ULAS-HiPR/tortilla/payload_carrier.kicad_pcb

## KiCad design payload_carrier.kicad_pcb (2026-10-15)

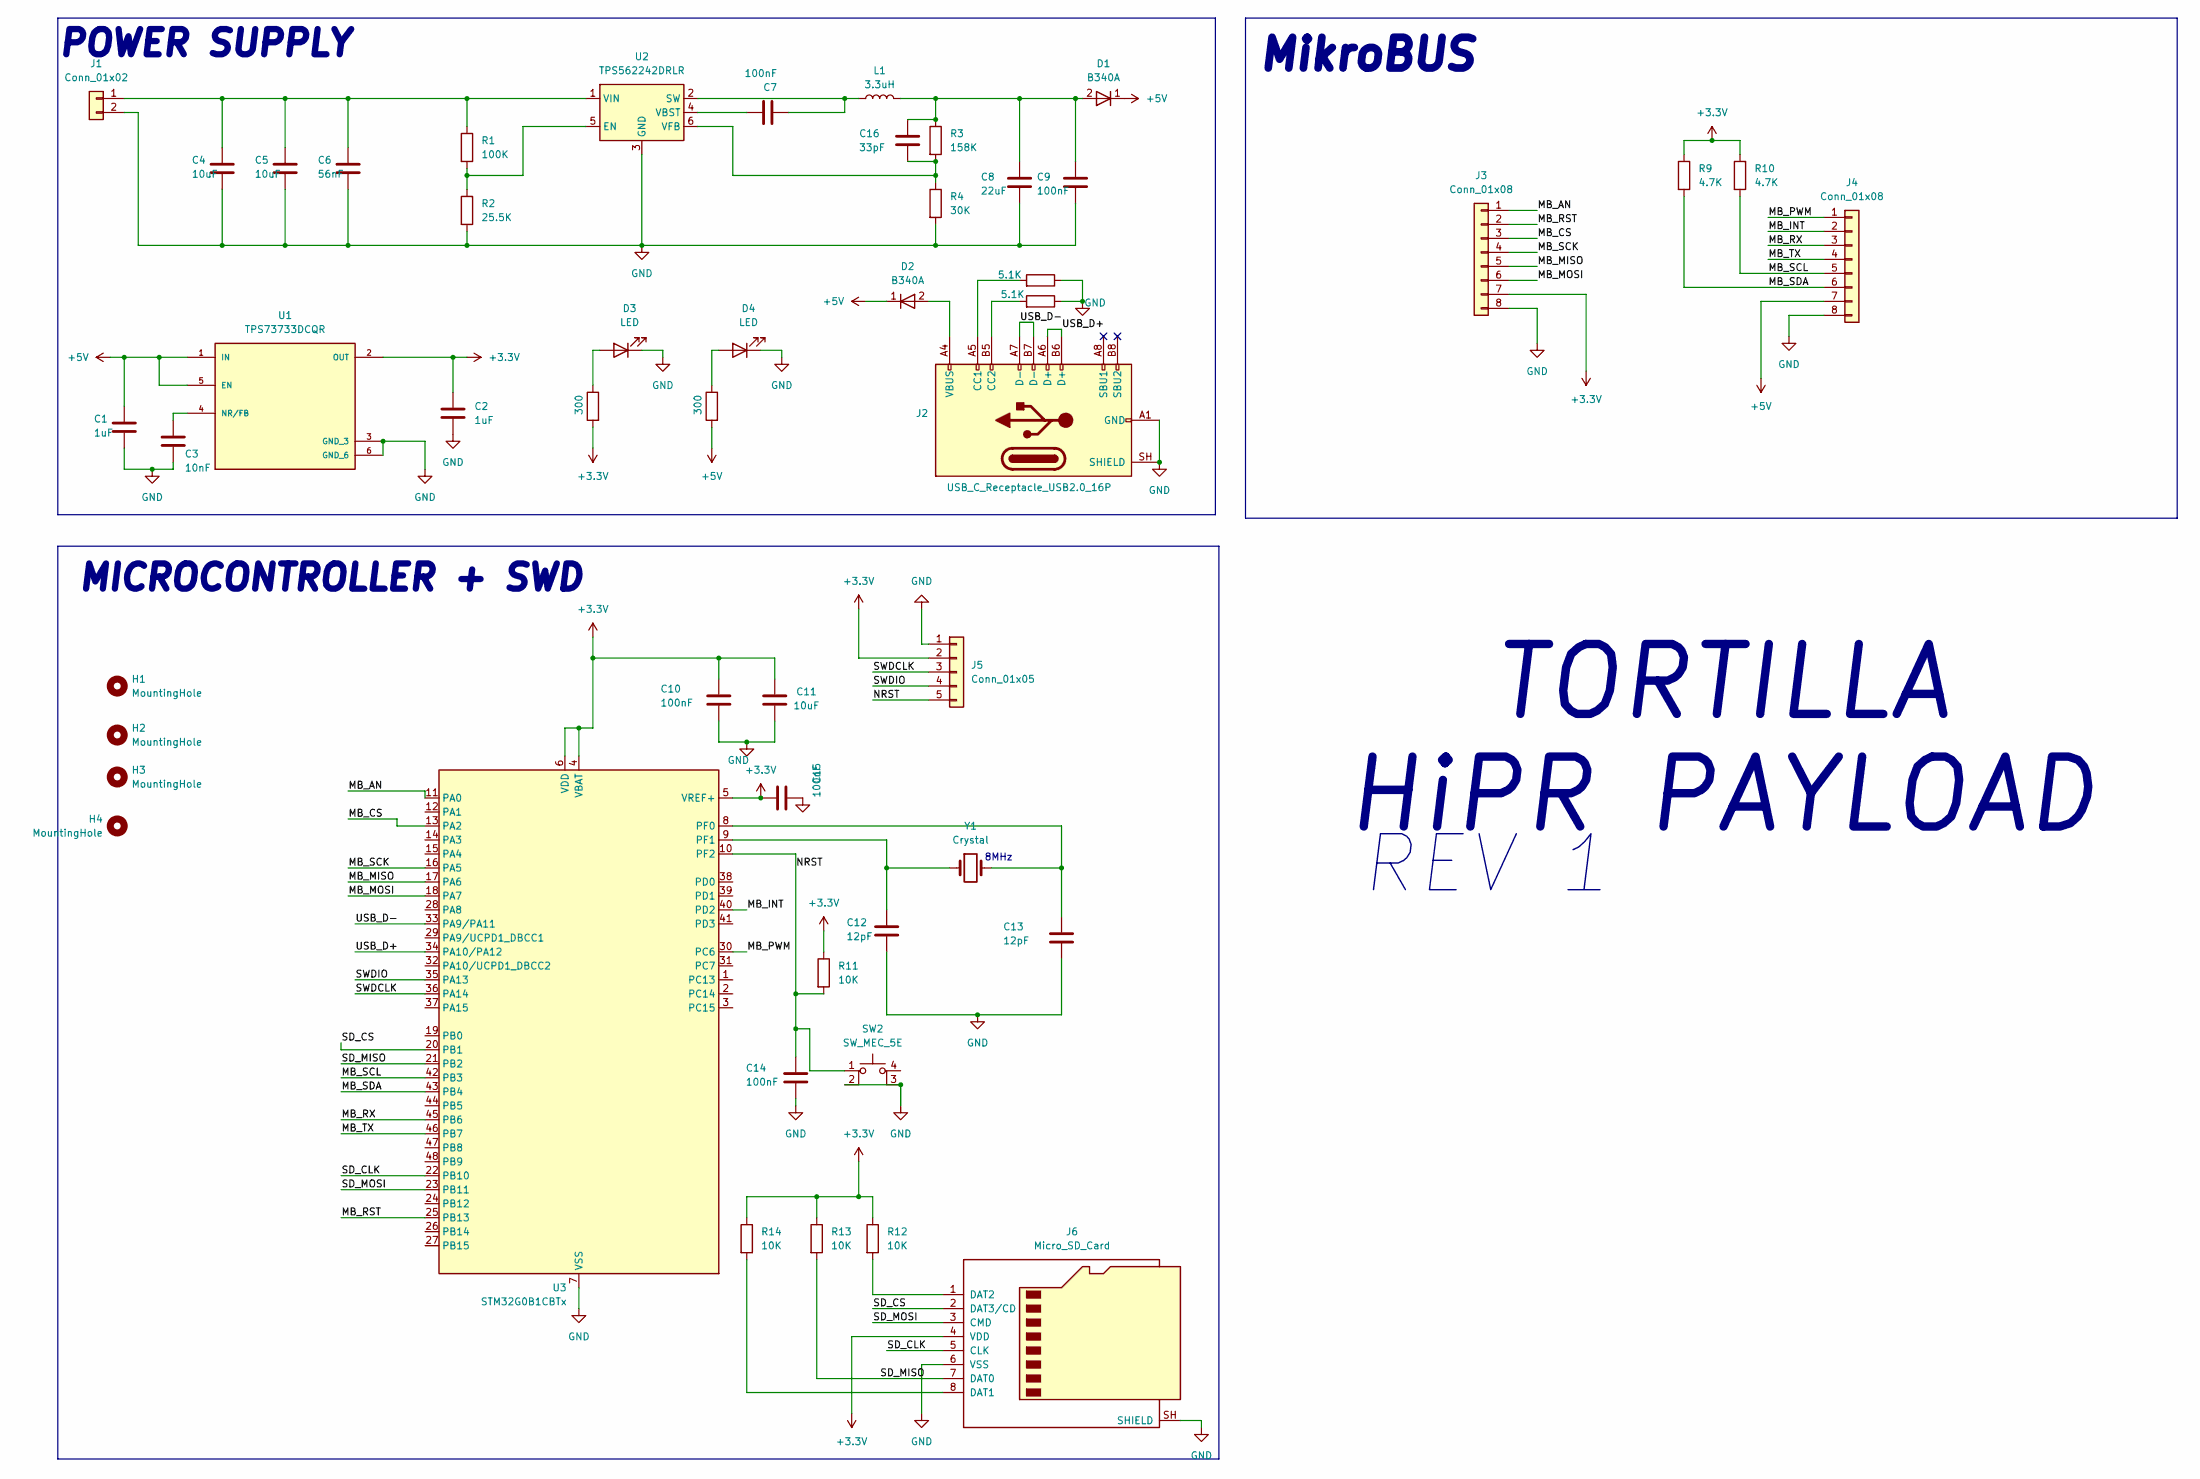
[picture p1: schematic payload_carrier.kicad_sch]

Parts:
C1, C2: 1uF; C_0603_1608Metric
C3: 10nF; C_0603_1608Metric
C4, C5, C11: 10uF; C_0805_2012Metric
C6: 56nF; C_0603_1608Metric
C7, C9, C10, C14, C15: 100nF; C_0603_1608Metric
C8: 22uF; C_0805_2012Metric
C12, C13: 12pF; C_0603_1608Metric
C16: 33pF; C_0603_1608Metric
D1, D2: B340A; D_SMA
D3, D4: LED; LED_0603_1608Metric
H1, H2, H3, H4: MountingHole; Mounting_Wuerth_WA-SMSI-M3_H0.5mm_9774005360
J1: Conn_01x02; JST_PH_B2B-PH-K_1x02_P2.00mm_Vertical
J2: USB_C_Receptacle_USB2.0_16P; USB_C_Receptacle_HRO_TYPE-C-31-M-12
J3, J4: Conn_01x08; PinSocket_1x08_P2.54mm_Vertical
J5: Conn_01x05; PinHeader_1x05_P2.54mm_Vertical
J6: Micro_SD_Card; microSD_HC_Wuerth_693072010801
L1: 3.3uH; L_Wuerth_MAPI-4020
R1: 100K; R_0603_1608Metric
R2: 25.5K; R_0603_1608Metric
R3: 158K; R_0603_1608Metric
R4: 30K; R_0603_1608Metric
R5, R6: 5.1K; R_0603_1608Metric
R7, R8: 300; R_0603_1608Metric
R9, R10: 4.7K; R_0603_1608Metric
R11, R12, R13, R14: 10K; R_0603_1608Metric
SW2: SW_MEC_5E; SW_SPST_B3SL-1002P
U1: TPS73733DCQR; IC_TPS73733DCQR; PARTREV R
U2: TPS562242DRLR; SOT-563
U3: STM32G0B1CBTx; LQFP-48_7x7mm_P0.5mm
Y1: Crystal; Crystal_SMD_5032-2Pin_5.0x3.2mm

Connections:
+3.3V: C2.1, C10.1, C11.1, C15.1, J3.7, J5.2, J6.4 (VDD), R7.2, R9.1, R10.1, R11.1, R12.1, R13.1, R14.1, U1.2 (OUT), U3.4 (VBAT), U3.5 (VREF+), U3.6 (VDD)
+5V: C1.1, D1.1 (K), D2.1 (K), J4.7, R8.2, U1.1 (IN), U1.5 (EN)
/MB_AN: J3.1, U3.11 (PA0)
/MB_CS: J3.3, U3.13 (PA2)
/MB_INT: J4.2, U3.40 (PD2)
/MB_MISO: J3.5, U3.17 (PA6)
/MB_MOSI: J3.6, U3.18 (PA7)
/MB_PWM: J4.1, U3.30 (PC6)
/MB_RST: J3.2, U3.25 (PB13)
/MB_RX: J4.3, U3.45 (PB6)
/MB_SCK: J3.4, U3.16 (PA5)
/MB_SCL: J4.5, R10.2, U3.42 (PB3)
/MB_SDA: J4.6, R9.2, U3.43 (PB4)
/MB_TX: J4.4, U3.46 (PB7)
/NRST: C14.1, J5.5, R11.2, SW2.1, U3.10 (PF2)
/SD_CLK: J6.5 (CLK), U3.22 (PB10)
/SD_CS: J6.2 (DAT3/CD), U3.20 (PB1)
/SD_MISO: J6.7 (DAT0), R13.2, U3.21 (PB2)
/SD_MOSI: J6.3 (CMD), U3.23 (PB11)
/SWDCLK: J5.3, U3.36 (PA14)
/SWDIO: J5.4, U3.35 (PA13)
/USB_D+: J2.A6 (D+), J2.B6 (D+), U3.34 (PA10/PA12)
/USB_D-: J2.A7 (D-), J2.B7 (D-), U3.33 (PA9/PA11)
GND: C1.2, C2.2, C3.2, C4.2, C5.2, C6.2, C8.2, C9.2, C10.2, C11.2, C12.2, C13.2, C14.2, C15.2, D3.1 (K), D4.1 (K), J1.2, J2.A1 (GND), J2.A12 (GND), J2.B1 (GND), J2.B12 (GND), J2.SH (SHIELD), J3.8, J4.8, J5.1, J6.6 (VSS), J6.SH (SHIELD), R2.2, R4.2, R5.1, R6.1, SW2.2, SW2.3 (K), U1.3 (GND_3), U1.6 (GND_6), U2.3 (GND), U3.7 (VSS)
unnamed: C8.1, C9.1, C16.1, D1.2 (A), L1.2, R3.1
unnamed: D2.2 (A), J2.A4 (VBUS), J2.A9 (VBUS), J2.B4 (VBUS), J2.B9 (VBUS)
unnamed: D3.2 (A), R7.1
unnamed: D4.2 (A), R8.1
unnamed: C4.1, C5.1, C6.1, J1.1, R1.1, U2.1 (VIN)
unnamed: J2.A5 (CC1), R6.2
unnamed: J2.B5 (CC2), R5.2
unnamed: J6.8 (DAT1), R14.2
unnamed: J6.1 (DAT2), R12.2
unnamed: C3.1, U1.4 (NR/FB)
unnamed: R1.2, R2.1, U2.5 (EN)
unnamed: C7.2, L1.1, U2.2 (SW)
unnamed: C7.1, U2.4 (VBST)
unnamed: C16.2, R3.2, R4.1, U2.6 (VFB)
unnamed: C13.1, U3.8 (PF0), Y1.2
unnamed: C12.1, U3.9 (PF1), Y1.1

Notes on the sheet:
MikroBUS
TORTILLA HiPR PAYLOAD
REV 1
MICROCONTROLLER + SWD
8MHz
POWER SUPPLY

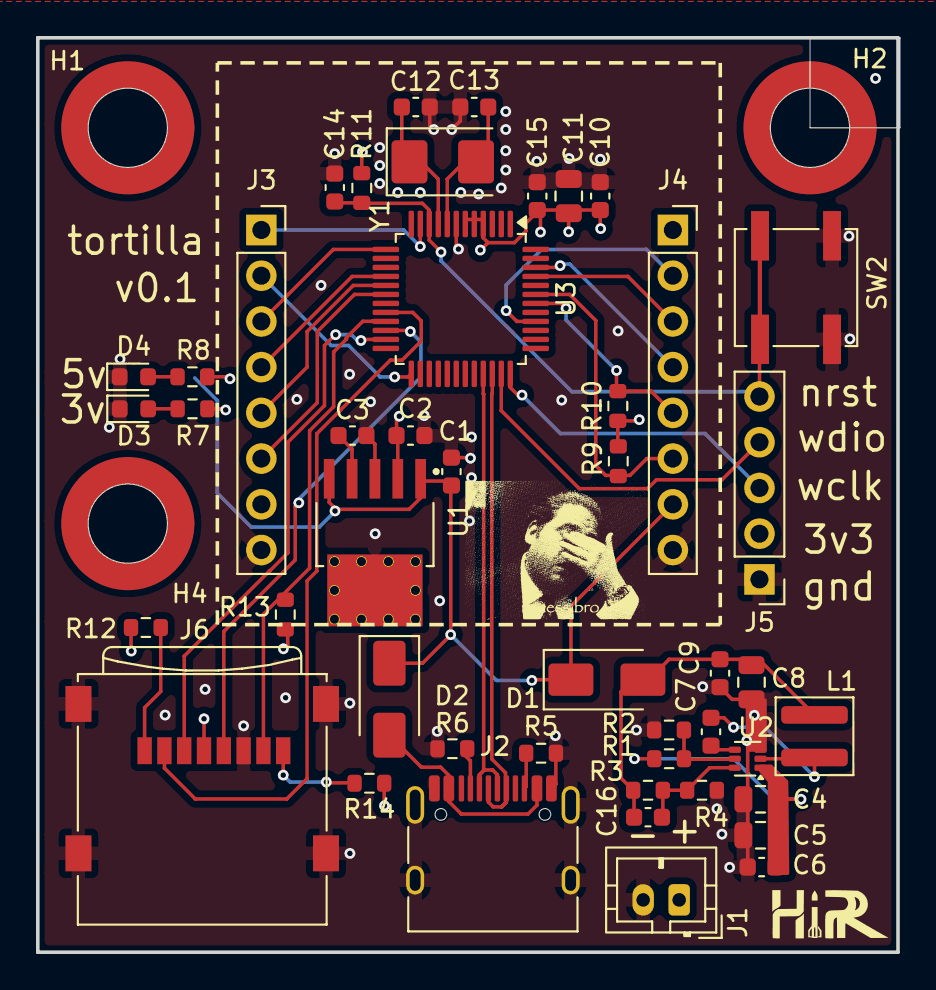
[picture p2: board payload_carrier.kicad_pcb from above]

Board: 4 copper layers, 47.8 x 50.8 mm, 49 parts (0 on the bottom side), 40 nets.
