ULAS-HiPR/tortilla/(commit log)

2026-10-05 kicad project aadded. With project specific libraries and schematics done
    [payload_carrier.kicad_pcb, payload_carrier.kicad_sch]
2026-10-05 Schematics removed, left block skeleton
    [payload_carrier.kicad_sch]
2026-10-05 Updated footprints and Library names
    [payload_carrier.kicad_sch]
2026-10-15 schematics finished for layout session
2026-10-15 Fix net bugs and assign footprints for layout session
    - SD_SCK label -> SD_CLK: SD card CLK now reaches PB10
    - MB_SDL label -> MB_SDA: PB4 now reaches mikroBUS SDA
    - SWDIO moved from PA15 to PA13
    - U1 footprint uses project lib nickname "My footprints"
    - VREF+ tied to +3.3V with new C15 100nF decoupling
    - Footprints on all parts except R11, C10, U2 (left for the
    footprint demo; stock 0603 R/C and SOT-563)
    - Y1 on 2-pad 5032 crystal, SW1 on SW_MEC_5GSH9 (pads match symbol),
    D1/D2 on SMA (value should read B340A)
    Claude-Session: https://claude.ai/code/session_01BZgeQ4ki9vnPRRu7w6dazn
2026-10-15 Wire USB data to STM32, add buck feedforward cap, pick L1
    - J2 D+ (A6/B6) -> PA12 (USB_DP), D- (A7/B7) -> PA11 (USB_DM);
    removed the four no-connect flags
    - C16 33pF across R3 (TI TPS562242 Table 8-2, 5 V row)
    - L1: Wurth WE-MAPI 4020 74438356033 (3.3uH, Isat 3.55A @10%),
    footprint Inductor_SMD:L_Wuerth_MAPI-4020
    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
2026-10-15 D1/D2 value B340 -> B340A to match SMA footprint
    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
2026-10-15 PCB Layout Prelim Changes
